danoscar/esp32-homekit-temp-humidity-sensor/README.md

# ESP32 HomeKit Temperature & Humidity Sensor









A USB-C powered Wi-Fi temperature and humidity sensor that shows up natively in the Apple Home app. An ESP32 devkit reads an SHT3x (SHT30/SHT31 family) or SHT40 breakout over I2C and publishes the readings to HomeKit using the [HomeSpan](https://github.com/HomeSpan/HomeSpan) library. No hub, bridge or cloud account is needed, and the whole build is four parts and four wires.

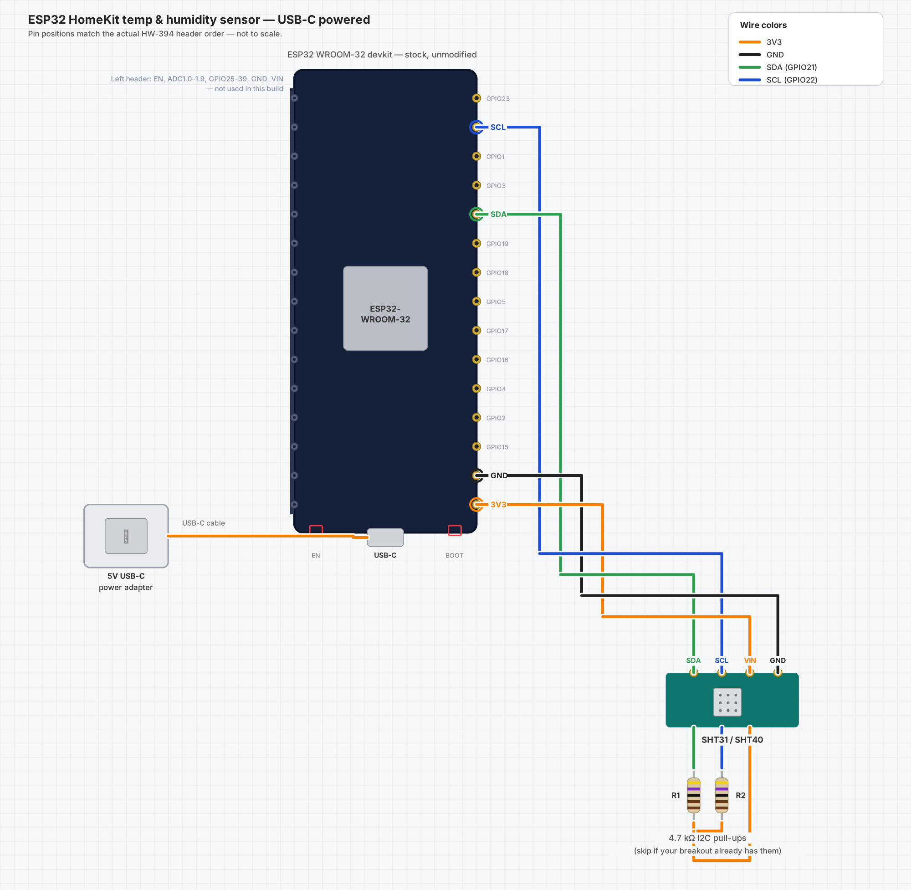
[picture p1: docs/wiring_diagram.png]
Wiring diagram


`docs/wiring_diagram.svg` is the same diagram as a scalable vector.

Current version: **0.3.0** (see [CHANGELOG.md](CHANGELOG.md)). Pre-release: not yet verified on finished hardware.

---

## Features

- Native Apple Home accessory: separate temperature and humidity tiles, usable in automations
- Always connected, so the Home app shows live values rather than stale ones
- Wi-Fi credentials entered once at setup and stored on the device; nothing is hard-coded in the sketch
- Stock devkit, no soldering to the board, no modification
- 3D-printable housing with a click-in sensor mount and an opening so the sensor reads outside air (based on a MakerWorld case, see [Housing](#housing))

## Bill of materials

| Qty | Part | Notes |
|---|---|---|
| 1 | ESP32-WROOM-32 devkit (USB-C, CH340C) | Developed on an HW-394 board; any standard 30/38-pin WROOM-32 devkit should work |
| 1 | SHT3x-DIS breakout (SHT30/SHT31 family), 12 × 12 mm, with a 4-pin right-angle header | Default address `0x44`. An SHT40 also works with a small code change |
| 2 | 4.7 kΩ resistors (optional) | I2C pull-ups. Skip them if your breakout already has pull-ups; the SHT3x-DIS board used here has two SMD resistors on SCL and SDA that look like on-board pull-ups |
| 1 | 3D-printed housing | See [Housing](#housing). PETG recommended for the lid |
| 1 | 4-pin Dupont female connector or 4 wires | To connect the breakout's header to the devkit |
| 1 | 5 V USB-C power adapter, ≥ 500 mA | Any phone charger, plus a cable long enough for where you mount it |

## Wiring

Power comes from the devkit's own USB-C port. The on-board regulator supplies the 3.3 V rail that feeds the sensor.

```
USB-C power adapter ──► devkit USB-C ──► on-board regulator ──► 3V3 rail ──► SHT31/40 VIN, pull-ups
```

I2C bus:

```
        3V3 ──┬────[4.7kΩ]────┬───────────────► GPIO21 (SDA) ───► SHT31/40 SDA
              │               │
              └────[4.7kΩ]────┴───────────────► GPIO22 (SCL) ───► SHT31/40 SCL

        SHT31/40 VIN ── 3V3
        SHT31/40 GND ── GND
        ADDR pin (if broken out) tied to GND → I2C address 0x44
```

| ESP32 pin | Function | Connects to |
|---|---|---|
| `3V3` | 3.3 V supply | SHT31/40 VIN, both pull-ups |
| `GND` | Ground | SHT31/40 GND |
| `GPIO21` | I2C SDA | SHT31/40 SDA, 4.7 kΩ pull-up to 3V3 |
| `GPIO22` | I2C SCL | SHT31/40 SCL, 4.7 kΩ pull-up to 3V3 |

The header order on the SHT3x-DIS board used here is **SCL, SDA, GND, VCC** (read the silkscreen on your own board). That differs from the order in the wiring diagram, so wire by pin name, not by position.

### Where the pins are on the HW-394

All four pins are on the **right-hand header** when the board is held with its USB-C connector at the bottom. Reading top to bottom:

`GPIO23`, **`GPIO22` (SCL)**, `GPIO1`, `GPIO3`, **`GPIO21` (SDA)**, `GPIO19`, `GPIO18`, `GPIO5`, `GPIO17`, `GPIO16`, `GPIO4`, `GPIO2`, `GPIO15`, **`GND`**, **`3V3`**

`3V3` is the pin closest to the USB-C end, with `GND` directly above it. SDA and SCL are several pins apart, so count carefully. Clone boards occasionally reorder pins, so check the silkscreen on your own board before connecting anything.

## Firmware

The sketch is in [`firmware/HomeKitTempSensor/HomeKitTempSensor.ino`](firmware/HomeKitTempSensor/HomeKitTempSensor.ino).

### Arduino IDE setup

Full step-by-step guide, including the packages to install: [`docs/arduino-ide-setup.md`](docs/arduino-ide-setup.md).

In short:

| Setting | Value |
|---|---|
| Board package | `esp32` by Espressif Systems (Boards Manager) |
| Libraries | **HomeSpan**, **Adafruit SHT31 Library** and **Adafruit BusIO** (Library Manager) |
| Board | **ESP32 Dev Module** |
| Partition Scheme | **Huge APP (3MB No OTA/1MB SPIFFS)** |
| Upload Speed | **115200** |

The partition scheme matters: a HomeSpan build is about 1.4 MB, and the default scheme allows only about 1.3 MB for the app, so compiling fails with `Sketch too big`.

### First-time Wi-Fi setup

No SSID or password is stored in the sketch. Enter them once; they are saved to the ESP32's flash and reused on every boot.

**Option A: setup hotspot.** The sketch calls `enableAutoStartAP()`, so a freshly flashed board with no stored credentials starts a hotspot on its own:

1. On a phone or laptop, join the Wi-Fi network **`HomeSpan-Setup`** (password **`homespan`**).
2. Choose your home network and enter its password on the page that opens.
3. The board saves the credentials and restarts.

**Option B: Serial Monitor.** Open the Serial Monitor at 115200 baud with the line ending set to *Newline*, type `W`, and follow the prompts. It scans for networks, asks which to join, and asks for the password.

To reopen the setup hotspot later, either type `A` in the Serial Monitor or use the BOOT button: hold it for 3 seconds to enter command mode, press briefly to step through the actions until you reach action 3 (Launch Access Point), then hold for 3 seconds to run it. Holding for 10 seconds performs a factory reset. The sketch assigns the BOOT button (GPIO0) as HomeSpan's control button.

### Status LED

The on-board LED (GPIO2) shows the Wi-Fi state:

| LED | Meaning |
|---|---|
| Blinking | Not connected to Wi-Fi yet: connecting, or waiting for first-time setup |
| Solid on | Connected to Wi-Fi and running |

If the connection drops, the LED goes back to blinking until it reconnects. It shows Wi-Fi only: a solid LED does not mean the accessory is paired in Home.

### Pairing with Apple Home

1. Open the Home app, tap **+**, then **Add Accessory**.
2. Choose **Temp Sensor** from the list of nearby accessories.
3. Enter the setup code. The default is **`466-37-726`**.
4. iOS warns that the accessory is not Apple-certified. That is expected for HomeSpan; accept it to continue.

Set your own code by typing `S` followed by eight digits in the Serial Monitor. Only a hash of the code is stored, so a forgotten code can't be read back; set a new one instead. A device that is stuck, or was paired and then removed from Home, can be reset with `U` (unpair) or `F` (factory reset).

### Reading interval

The sensor is read and published every 15 minutes by default. Change `READ_INTERVAL_MS` at the top of the sketch (for example `60000` for every minute).

### Troubleshooting uploads

If the upload fails with `Unable to verify flash chip connection`, set Upload Speed to 115200 and use the BOOT and EN sequence. The full troubleshooting table is in [`docs/arduino-ide-setup.md`](docs/arduino-ide-setup.md#troubleshooting).

## Prototype

Breadboard prototype powered over USB-C, running the v0.3.0 firmware. The red LED is the devkit's power LED.

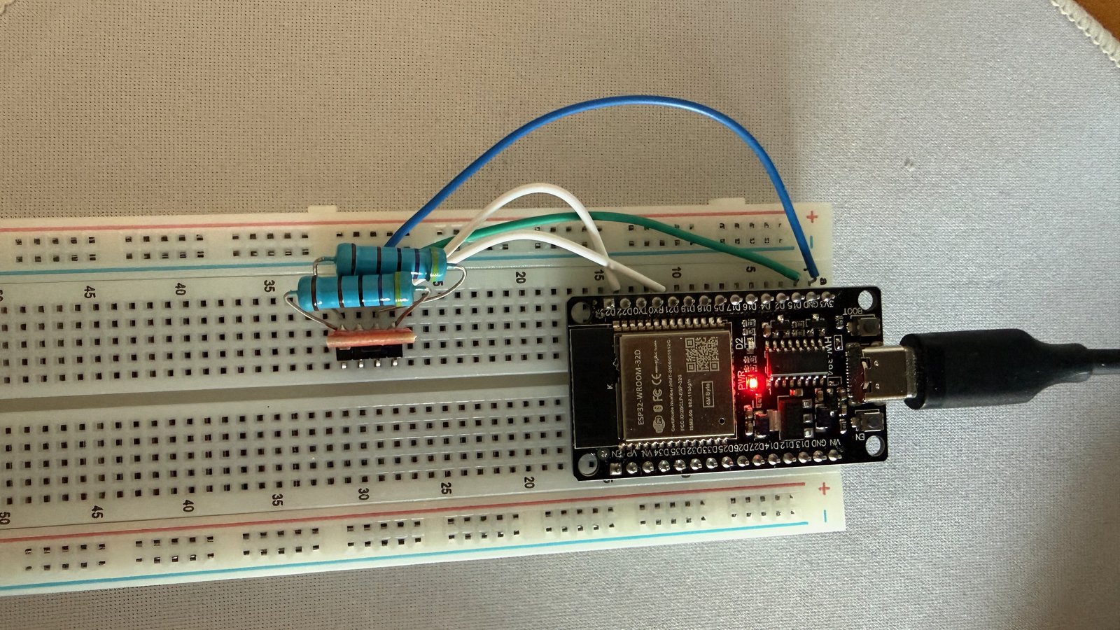
[picture p2: docs/images/prototype-breadboard.jpg]
ESP32 devkit and SHT3x on a breadboard


Close-up of the SHT3x breakout wired to the devkit (SDA, SCL, 3V3 and GND):

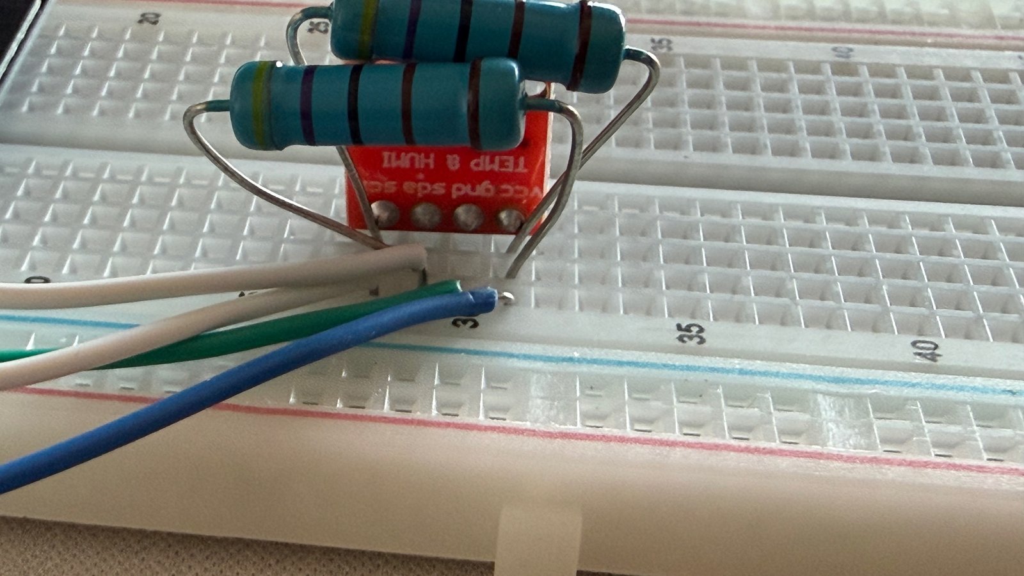
[picture p3: docs/images/sensor-wiring.jpg]
SHT3x breakout wiring


### In the Home app

The sensor appears as two tiles, temperature and humidity, and rolls up into the Climate summary:

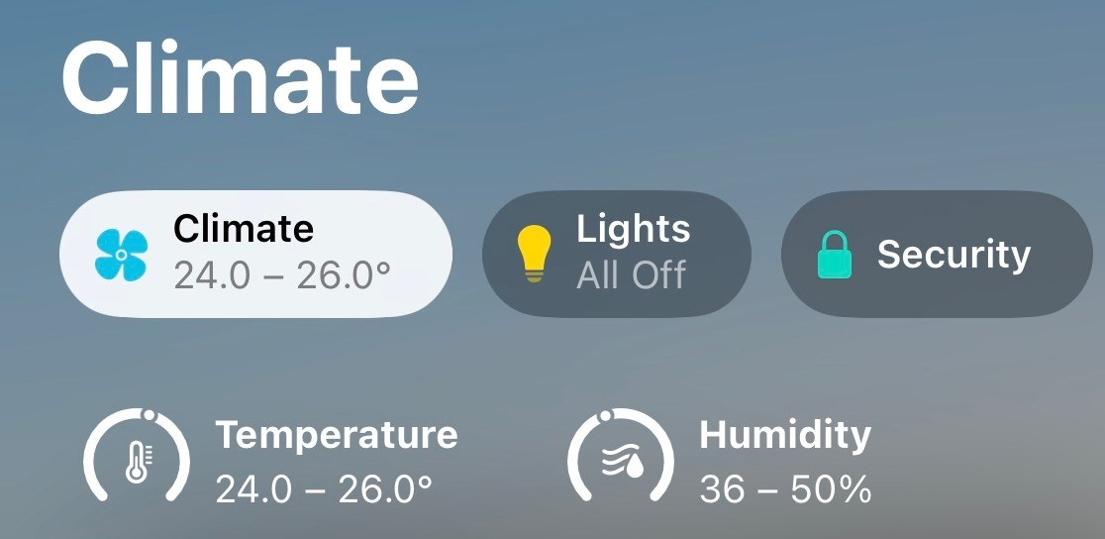
[picture p4: docs/images/homekit-show.jpg]
Climate summary in the Home app


<p>
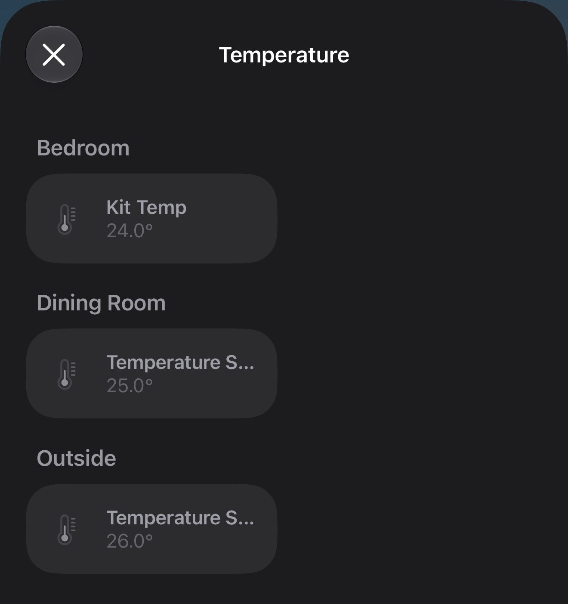
[picture p5: docs/images/homekit-temperature.jpg]
Temperature tile in the Home app

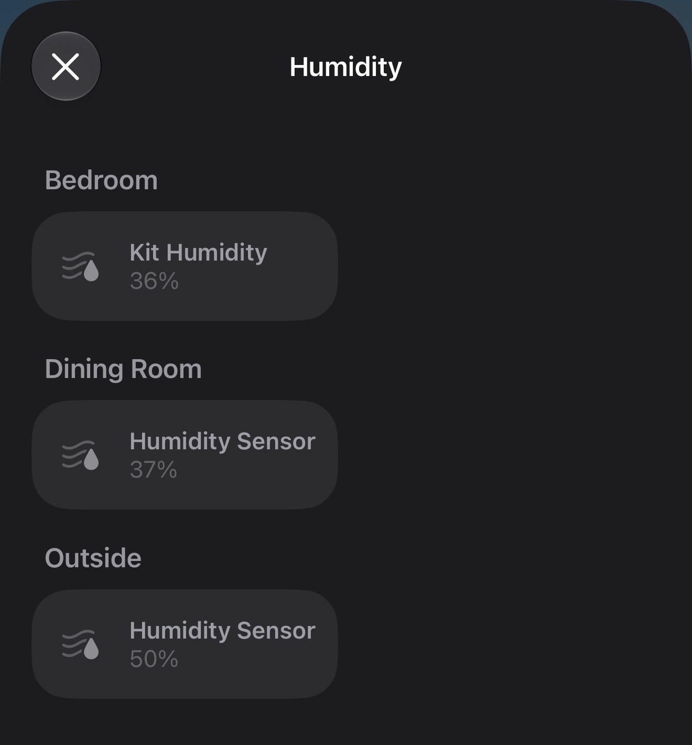
[picture p6: docs/images/homekit-humidity.jpg]
Humidity tile in the Home app

</p>

## Housing

The housing is the **[ESP Smart Home Case | Parametric | Antenna](https://makerworld.com/en/models/2540084-esp-smart-home-case-parametric-antenna)** by **i-BoxIt** on MakerWorld. It is a snap-fit two-part case for ESP boards. This project adds a mount for the SHT3x-DIS breakout to its lid:

- the sensor board clicks into the lid on two hooks, with two locating pegs and no screws
- the sensor chip sits over a vent opening in the lid, so it reads outside air rather than the air inside the case
- the right-angle header points toward the middle of the lid so a Dupont connector can slide on

**The case files are not in this repository.** The original is licensed under MakerWorld's *Standard Digital File License*, which does not allow sharing or hosting the original or modified files. Download the case from the link above, then run the script in [`hardware/enclosure/`](hardware/enclosure/) to produce the modified lid for your own use. The full instructions, assumptions and printing notes are in [`hardware/enclosure/README.md`](hardware/enclosure/README.md).

Status: the modified lid has been checked in software but **has not been printed yet**, and the fit of the devkit in the base has not been verified. Print the lid on its own as a fit test first.

Mount the sensor away from the USB adapter and the ESP32's own heat. The board warms the air inside the case a little, so the vent opening matters for accurate readings.

## Repository layout

```
.
├── README.md
├── CHANGELOG.md
├── LICENSE
├── VERSION
├── docs/
│   ├── arduino-ide-setup.md
│   ├── images/
│   ├── wiring_diagram.png
│   └── wiring_diagram.svg
├── firmware/
│   └── HomeKitTempSensor/
│       └── HomeKitTempSensor.ino
└── hardware/
    └── enclosure/
        ├── README.md
        ├── add_sht3x_mount.py
        ├── requirements.txt
        ├── mount_layout.png
        └── mount_section.png
```

## Versioning

The project uses [Semantic Versioning](https://semver.org/) and each release is a git tag (`v0.1.0`, and so on). To release: update `VERSION`, `FW_VERSION` in the sketch and `CHANGELOG.md`, commit, then `git tag -a vX.Y.Z -m "vX.Y.Z"`.

## Licence

The firmware, scripts and documentation in this repository are released under the [MIT Licence](LICENSE): free to use, copy, modify and share, including commercially, as long as the copyright notice is kept. The third-party housing is **not** covered by this licence and is not included (see [Housing](#housing)). HomeSpan (MIT) and the Adafruit libraries (BSD) keep their own licences.

## Credits

- Housing: [ESP Smart Home Case | Parametric | Antenna](https://makerworld.com/en/models/2540084-esp-smart-home-case-parametric-antenna) by i-BoxIt (MakerWorld Standard Digital File License). The case is not redistributed here.
- HomeKit support: [HomeSpan](https://github.com/HomeSpan/HomeSpan).
- Sensor driver: Adafruit SHT31 Library.

## Notes

- HomeSpan is an open-source implementation of the HomeKit Accessory Protocol. It is not Apple-certified, which is why iOS shows a warning at pairing. That is fine for personal use.
- The sketch folder is named to match the `.ino` file, which the Arduino IDE requires.
