danoscar/esp32-homekit-temp-humidity-sensor/hardware/enclosure/case_lid.stl

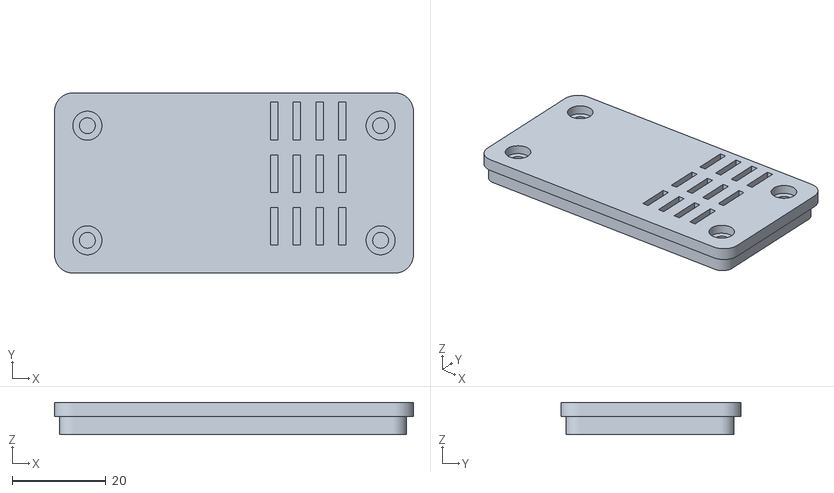
[picture p10: CAD file, 2026-10-11, last stored version]
hardware/enclosure/case_lid.stl
76.4 x 38.4 x 6.90
