danoscar/esp32-homekit-temp-humidity-sensor/(commit log)

2026-10-11 Initial release v0.1.0
    HomeSpan firmware for an ESP32 devkit with an SHT31, wiring diagram,
    printable enclosure, README and changelog.
    Claude-Session: https://claude.ai/code/session_01V3pcwSoAYjjFSVYZ5hq1dB
    [case_base.stl, case_lid.stl, sensor_case.scad]
2026-10-11 Status LED: blink while waiting for Wi-Fi, solid when connected (v0.2.0)
    The on-board LED (GPIO2) is now driven by the sketch from WiFi.status()
    instead of HomeSpan's status LED patterns.
    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
2026-10-11 v0.3.0: MakerWorld-based housing with SHT3x snap mount, Arduino IDE guide
    - Housing script that builds the modified lid from the case downloaded from
    MakerWorld (case files are not redistributable, so no STLs are committed)
    - docs/arduino-ide-setup.md with the board package, libraries and settings
    - README, changelog and version updated; generic enclosure removed
    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
    [case_base.stl, case_lid.stl, sensor_case.scad]
2026-10-11 Add MIT licence, images folder, record LED verified
    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
2026-10-11 Add prototype photos (metadata stripped) to README
    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
