danoscar/esp32-homekit-temp-humidity-sensor/(notices)

Notices in the files:
README.md:
License: MIT
